pthomas/linuxstamp/linuxstampI/Bom_linuxstamp_rev1.0.5.xls

Sheet: bom
Part | Description | Value | Tolerance | Package | Qty | Digikey pt# | Manufacturer | Manufacturer PT# | Price/1 | Price/100 | Subtotal/1 | Subtotal/100
R1, R2, R12 | Resistor | 10k | 5.00% | 0402 | 3 | 541-10KJCT-ND | Vishay | CRCW040210K0JNED | $0.04 | $0.02 | $0.12 | $0.07
R4, R5, R6, R11, R25, R27, R33 | Resistor | 0 | 5.00% | 0402 | 9 | 541-0.0JCT-ND | Vishay | CRCW04020000Z0ED | $0.04 | $0.02 | $0.36 | $0.21
R3, R7, R8, R19, R24 | Resistor | 200 | 5.00% | 0402 | 5 | 311-200JRCT-ND | Yageo | RC0402JR-07200RL | $0.08 | $0.04 | $0.40 | $0.22
R13 | Resistor | 1.27k | 1.00% | 0402 | 1 | 541-1.27KLCT-ND | Vishay | CRCW04021K27FKED | $0.04 | $0.02 | $0.04 | $0.02
R14 | Resistor | 1.96k | 1.00% | 0402 | 1 | 541-1.96KLCT-ND | Vishay | CRCW04021K96FKED | $0.04 | $0.02 | $0.04 | $0.02
R9-R10, R15-R18 | Resistor | 100k | 5.00% | 0402 | 6 | 541-100KLCT-ND | Vishay | CRCW0402100KFKED | $0.04 | $0.02 | $0.24 | $0.12
R20, R21 | Resistor | 1k | 5.00% | 0402 | 2 | 541-1.00KLCT-ND | Vishay | CRCW04021K00FKED | $0.04 | $0.03 | $0.08 | $0.05
R22 | Resistor | 1M | 5.00% | 1206 | 1 |  |  |  | $0.07 | $0.04 | $0.07 | $0.04
R29, R31 | Resistor | 887k |  | 0402 | 2 |  |  |  | $0.07 | $0.04 | $0.15 | $0.08
R30 | Resistor | 442k |  | 0402 | 1 |  |  |  | $0.07 | $0.04 | $0.07 | $0.04
R32 | Resistor | 197k |  | 0402 | 1 |  |  |  | $0.07 | $0.04 | $0.07 | $0.04
C1-C28, C31-C37, C40, C41, C45, C46, C49, C62 | Capacitor | 100nF | 10.00% | 0402 | 38 | 399-3026-1-ND | Kemet | C0402C104K9PACTU | $0.04 | $0.03 | $1.67 | $0.99
C29, C30, C52, C53 | Capacitor | 18pF | 5.00% | 0403 | 4 | 490-1281-1-ND | Murata | GRM1555C1H180JZ01D | $0.03 | $0.20 | $0.14 | $0.81
C39, C64 | Capacitor | 4.7uF | 20.00% | 0603 | 2 | 445-1417-1-ND | TDK | C1608X5R0J475M | $0.33 | $0.20 | $0.66 | $0.39
C38, C42, C43, C44 | Capacitor | 10uF | 10.00% | 0805 | 4 | 587-1299-1-ND | Tayio Uden | LMK212BJ106KD-T | $0.36 | $0.21 | $1.45 | $0.86
C50, C51 | Capacitor | 12pF | 5.00% | 0402 | 2 | 490-1279-1-ND | Murata | GRM1555C1H120JZ01D | $0.04 | $0.03 | $0.09 | $0.05
C54 | Capacitor | 680p | 10.00% | 0402 | 1 | 399-1027-1-ND | Kemet | C0402C681K5RACTU | $0.03 | $0.02 | $0.03 | $0.02
C55 | Capacitor | 5.6n | 10.00% | 0402 | 1 | PCC2143CT-ND | Panasonic | ECJ-0EB1A563K | $0.03 | $0.02 | $0.03 | $0.02
C56 | Capacitor | 470p | 10.00% | 0402 | 1 | 399-1025-1-ND | Kemet | C0402C471K5RACTU | $0.02 | $0.01 | $0.02 | $0.01
C57 | Capacitor | 4.7n | 10.00% | 0402 | 1 | 399-3072-1-ND | Kemet | C0402C472K5RACTU | $0.02 | $0.01 | $0.02 | $0.01
C63 | Capacitor | 10nF | 10.00% | 0402 | 1 | 399-3066-1-ND | Kemet | C0402C103K5RACTU | $0.02 | $0.01 | $0.02 | $0.01
C58 | Capacitor | 10nF |  | 1206 | 1 | 478-2956-1-ND | AVX | 1206GC102KAT1A | $0.66 | $0.39 | $0.66 | $0.39
C47, C48 | Capacitor | 22pF |  | 0402 | 2 |  |  |  |  |  | $0.00 | $0.00
C65-C68 | Capacitor | 100uF |  | 6032-28 | 4 | 718-1055-1-ND | Vishay/Sprague | 293D107X9010C2TE3 | $0.36 | $0.20 | $1.44 | $0.78
L6, L7 | Inductor | 2.2uH | 10.00% | 1812 | 2 | 495-1757-1-ND | EPCOS | B82432T1222K | $0.49 | $0.37 | $0.98 | $0.74
F1 | FUSE RESETTABLE 2.0A HOLD SMD | .02ohm |  | 1206 | 1 | MF-NSMF200-2CT-ND | Bourns | MF-NSMF200-2 | $0.88 | $0.69 | $0.88 | $0.69
D1 | TVS ZENER DUAL 24W CA 5.6V SOT23 | 5.6V |  | SOT23 | 1 | MMBZ5V6ALT1GOSCT-ND | ON | MMBZ5V6ALT1G | $0.36 | $0.14 | $0.36 | $0.14
JP1 | CONN MINI USB RCPT RA TYPE B SMD |  |  |  | 1 | A31727CT-ND | Tyco | 1734035-2 | $1.76 | $1.06 | $1.76 | $1.06
JP2 | CONN USB JACK TYPE A HORIZON R/A |  |  |  | 1 | 151-1080-ND | EDAC | 690-004-621-013 | $0.81 | $0.57 | $0.81 | $0.57
JP3 | CONN PULSEJACK 1PORT POETHERNET |  |  |  | 1 | 553-1367-ND | Pulse | JK0-0025NL | $7.83 | $4.26 | $7.83 | $4.26
JP5 | TERM BLOCK HEADER 2POS 5MM BLACK |  |  |  | 1 | 277-1645-ND | Phoenix Contact | 1933189 | $0.10 | $0.07 | $0.10 | $0.07
SD1 | CONN SD CARD |  |  |  | 1 | 3M5646CT-ND | 3M | SD-RSMT-2-MQ-WF | $1.70 | $1.00 | $1.70 | $1.00
FB1-FB4 | FERRITE CHIP 30 OHM 1.7A 0402 |  |  | 0402 | 4 | 445-2979-1-ND | TDK | MPZ1005S300C | $0.06 | $0.05 | $0.24 | $0.19
LED1-LED4 | LED GRN HI BRT SS TYPE LO CUR S |  |  | 0603 | 4 | P525CT-ND | Panasonic | LNJ308G8TRA | $0.33 | $0.28 | $1.32 | $1.10
SW1 | SWITCH TACT 6X3.5MM SMD 130GF |  |  | 6x3.5 | 1 | 450-1140-ND | Tyco / Alcoswitch | FSMSM | $0.89 | $0.46 | $0.89 | $0.46
U1 | IC ARM9 MCU 208 PQFP |  |  | LQFP208 | 1 | AT91RM9200-QU-002-ND | Atmel | AT91RM9200-QU-002 | $16.65 | $13.58 | $16.65 | $13.58
U2 | IC SDRAM 256MB 133MHZ 54-TSOP | 32MB SDRAM |  | TSOPII-54 | 1 | 557-1059-1-ND | Micron | MT48LC16M16A2P-75:D TR | $9.92 | $6.79 | $9.92 | $6.79
U3 | IC TXRX PHY 10/100 3.3V 48LQFP |  |  | TQFP48 | 1 | 576-1028-1-ND | Micrel | KS8721BL | $3.98 | $2.48 | $3.98 | $2.48
U4 | IC EMI FLTR/LINE TERM SOT323-5L |  |  | SOT323-5 | 1 | 497-3086-1-ND | ST Microelectronics | USBDF01W5 | $0.79 | $0.48 | $0.79 | $0.48
U5 | IC DATAFLASH 64M 2.7 DUAL 8CASON | 8MB Dataflash |  | CASON-8 | 1 | AT45DB642D-CNU-ND | Atmel | AT45DB642D-CNU | $6.99 | $4.65 | $6.99 | $4.65
U6 | IC FTDI FT232RQ USB-SRL 32-QFN |  |  | QFN32 | 1 | 604-00047CT-ND | FTDI | FT232RQ | $8.40 | $3.11 | $8.40 | $3.11
U7 | IC REG DC/DC DUAL STEPDOWN 10DFN |  |  | DFN-10 | 1 | LTC3407IDD-2#PBF-ND | Linear | LTC3407-2 | $4.21 | $3.47 | $4.21 | $3.47
X1 | CRYSTAL 18.432MHZ 18PF FUND SMD | 18.432Mhz |  | 3.2x2.5 | 1 | 535-9135-1-ND | Abracon | ABM8-18.432MHZ-B2-T | $1.93 | $1.23 | $1.93 | $1.23
X2 | CRYSTAL 32.768KHZ 12.5PF SMD | 32.768khz |  | MM20SS | 1 | XC488CT-ND | ECS | ECS-.327-12.5-17-TR | $1.08 | $0.72 | $1.08 | $0.72
X3 | CRYSTAL 25.000MHZ 18PF FUND SMD | 25.000Mhz |  | 3.2x2.5 | 1 | 535-9140-1-ND | Abracon | ABM8-25.000MHZ-B2-T | $1.93 | $1.23 | $1.93 | $1.23
No populate Designators
R26, R28
JP4 | CONN HEADER 10POS .100" VERT TIN |  |  |  | 1 | WM17451-ND | Molex/Waldom | 15-91-2100 | $1.01 | $0.59 | $1.01 | $0.59
C60 |  | 100pF |  | 0402 | 1 |  |  |  |  |  | $0.00 | $0.00
Non Soldered
JP5 connecter | TERM BLOCK PCB 2POS 5.0MM GREEN |  |  |  | 1 | 277-1607-ND | Phoenix Contact | 1934861 | $0.34 | $0.25 | $0.34 | $0.25
Total |  |  |  |  |  |  |  |  |  |  | $81.98 | $54.11

Sheet: changelog
Date | Version | Changes
2007-04-19 | 1.0.1 | Added JP5 and connector for JP5, and C41
 |  | Changed C39, C64 tolerence to +/- 20%
 |  | changed C50, C51
 |  | added and item column
2007-04-29 | 1.0.2 | Added c45, c46
 |  | Added F1
2007-05-11 | 1.0.3 | Switched ethernet jack
2008-04-26 | 1.0.4 | added some subs, and passives for power supply
