pthomas/linuxstamp/linuxstampII/bom_ls2_1.0.7.xls

Sheet: wanda_100_bom
Part | Description | Value | Tolerance | Package | Qty | Digikey pt# | Manufacturer | Manufacturer PT# | Price/1 | Price/100 | Subtotal/1 | Subtotal/100
R1, R4, R5, R6, R10 |  | 470k |  | 0402 | 5 | 541-470KLCT-ND | Vishay/Dale | CRCW0402470KFKED | $0.08 | $0.04 | $0.42 | $0.22
R14 |  | 665k |  | 0402 | 1
R12 |  | 887k |  | 0402 | 2 | 541-887KLCT-ND | Vishay/Dale | CRCW0402887KFKED | $0.08 | $0.04 | $0.17 | $0.09
R13 |  | 196k |  | 0402 | 1 | 541-196KLCT-ND | Vishay/Dale | CRCW0402196KFKED | $0.08 | $0.04 | $0.08 | $0.04
R11 |  | 442k |  | 0402 | 1 | 541-442KLCT-ND | Vishay/Dale | CRCW0402442KFKED | $0.08 | $0.04 | $0.08 | $0.04
R15 |  | 200 |  | 0402 | 1 | 541-200LCT-ND | Vishay/Dale | CRCW0402200RFKED | $0.08 | $0.04 | $0.08 | $0.04
R20, R23, R24, R25, R30, R38 |  | 100k |  | 0402 | 6 | 541-100KLCT-ND | Vishay/Dale | CRCW0402100KFKED | $0.08 | $0.04 | $0.50 | $0.27
R27 |  | 6.49k |  | 0402 | 1 | 541-6.49KLCT-ND | Vishay/Dale | CRCW04026K49FKED | $0.08 | $0.04 | $0.08 | $0.04
R8, R29 |  | 1k |  | 0402 | 2 | 541-1.00KLCT-ND | Vishay/Dale | CRCW04021K00FKED | $0.08 | $0.04 | $0.17 | $0.09
R9, R19, R39, R40 |  | 10k |  | 0402 | 4 | 541-10.0KLCT-ND | Vishay/Dale | CRCW040210K0FKED | $0.08 | $0.04 | $0.33 | $0.18
R31, R32, R33, R34 |  | 49.9 |  | 0402 | 4 | 541-49.9LCT-ND | Vishay/Dale | CRCW040249R9FKED | $0.08 | $0.04 | $0.33 | $0.18
R17, R18, R21, R22, R26, R28 |  | 0 |  | 0402 | 6 | 541-0.0JCT-ND | Vishay/Dale | CRCW04020000Z0ED | $0.07 | $0.04 | $0.44 | $0.24
C1, C2, C3, C4, C5, C6, C7, C8, C9, C10, C11, C12, C13, C14, C15, C16, C17, C18, C19, C20, C21, C22, C23, C24, C25, C33, C34, C38, C45, C48, C50, C51, C52, C56, C57 | Capacitor | 100nF | 10.00% | 0402 | 35 | 399-3521-1-ND | Kemet | C0402C104K4RACTU | $0.03 | $0.02 | $0.91 | $0.55
C28, C29, C30, C31 | Capacitor | 18pF |  | 0402 | 4 | 490-1281-1-ND | Murata | GRM1555C1H180JZ01D | $0.02 | $0.01 | $0.09 | $0.05
C26, C27 | Capacitor | 12.5pF |  | 0402 | 2 | 490-1279-1-ND | Murata | GRM1555C1H120JZ01D | $0.02 | $0.01 | $0.04 | $0.03
C35, C36, C37, C39, C40, C43, C44 | Capacitor | 10uF | 10.00% | 0805 | 7 | 399-3138-1-ND | Kemet | C0805C106K9PACTU | $0.24 | $0.14 | $1.69 | $1.00
C41, C42 | Capacitor | 22pF |  | 0402 | 2 | 399-1015-1-ND | Kemet | C0402C220J5GACTU | $0.02 | $0.01 | $0.05 | $0.03
C47, C49, C54, C55 | Capacitor | 100uF |  | 6032-28 | 4 | 718-1055-1-ND | Vishay/Sprague | 293D107X9010C2TE3 | $0.39 | $0.18 | $1.56 | $0.72 | D | 500 |  | 90
C53 | Capacitor | 100pF |  | 0402 | 1 | 399-3194-1-ND | Kemet | C0402C101J5GACTU | $0.02 | $0.01 | $0.02 | $0.01
C46 | Capacitor | 1nF | 10.00% | 0402 | 1 | 399-1032-1-ND | Kemet | C0402C102K5RACTU | $0.03 | $0.02 | $0.03 | $0.02
D2 | TVS | 3V |  | Sot23 | 1 | MMBZ5V6AL-FDICT-ND | Diodes Inc | MMBZ5V6AL-7-F | $0.42 | $0.18 | $0.42 | $0.18
L6, L7 | Inductor | 2.2uH | 10.00% | 1812 | 2 | 495-1757-6-ND | EPCOS | B82432T1222K | $0.49 | $0.58 | $0.98 | $1.16 | D | 280 | 7 | 162.288 | 169.288
FB1, FB2, FB3, FB4, FB5, FB6 | FERRITE CHIP 30 OHM 1.7A 0402 |  |  | 0402 | 6 | 445-2979-1-ND | TDK | MPZ1005S300C | $0.06 | $0.05 | $0.36 | $0.29
LED1(3.3v) | LED GRN HI BRT SS TYPE LO CUR S |  |  | 0603 | 1 | P525DKR-ND | Panasonic | LNJ308G8TRA | $0.33 | $0.28 | $0.33 | $0.28 | D | 140 | 7 | 38.668 | 45.668
JP1 | Memory Card Headers MICROSD 8P P/P SMT POLARIZED |  |  |  | 1 | 3M5607DKR-ND | 3M | 2908-05WB-MG | $1.22 | $0.93 | $1.22 | $0.93 | D | 140 | 7 | 130.508 | 137.508
JP2 | CONN USB JACK TYPE A HORIZON R/A |  |  |  | 1 | 151-1080-ND | EDAC | 690-004-621-013 | $0.81 | $0.57 | $0.81 | $0.57 | D | 140 |  | 80.08 | 80.08
JP3 | CONN PULSEJACK 1PORT 10/100B-TX |  |  |  | 1 | 553-1349-ND | Pulse | J0026D21BNL | $7.05 | $3.20 | $7.05 | $3.20 | A | 140
 |  |  |  |  |  |  |  | J0026D21FNL
JP5 | CONN HEADER VERT 5POS .100 TIN |  |  |  | 1 | A31115-ND | Tyco | 3-644456-5 | $0.33 | $0.21 | $0.33 |  | D | 140 |  | 29.89 | 29.89
JP6, JP7 | CONN HEADER 40POS .8MM DUAL SMD |  |  |  | 2 | 609-1670-1-ND | FCI | 61083-042422LF | $3.64 | $1.33 | $7.28 | $0.21 | D | 140 |  | 29.89 | 29.89
 |  |  |  |  |  | 609-1669-1-ND | FCI | 61083-042402LF |  |  |  | $2.66 | A | 800
SW1 (RESET) | SWITCH TACT 6X3.5MM SMD 130GF |  |  |  | 1 | 450-1140-ND | Tyco / Alcoswitch | FSMSM | $0.58 | $0.14 | $0.58
U1 | IC ARM9 MCU 217-LFBGA |  |  | 217-LFBGA | 1 |  | Atmel | AT91SAM9G20 | $14.62 | $8.00 | $14.62 | $0.14 | A | 1000
U2 | IC SDRAM 256MB 133MHZ 54-TSOP | 32MB SDRAM |  | TSOPII-54 | 1 | 557-1059-1-ND | Micron | MT48LC16M16A2P-75:D TR | $7.84 | $5.00 | $7.84 | $8.00 | N | 125
U3 | IC NAND FLASH 2GB 3.3V 48-TSOP | 256MB Nand Flash |  | 48-TSOP | 1 | 557-1355-1-ND | Micron | MT29F2G08AADWP-ET:D TR | $8.26 | $5.80 | $8.26 | $5.00 | N | 100
U4 | IC TXRX PHY 10/100 LV/LP 32-MLF |  |  | 32-MLF | 1 | 576-1645-1-ND | Micrel | KSZ8041NL TR | $2.27 | $1.41 | $2.27 | $5.80 | N | 100
U6 | IC EMI FLTR/LINE TERM SOT323-5L |  |  | SOT323-5 | 1 | 497-3086-1-ND | ST Microelectronics | USBDF01W5 | $0.77 | $0.53 | $0.77 | $1.41 | D | 110 | 7 | 155.54 | 162.54
U7 | IC REG DC/DC DUAL STEPDOWN 10DFN |  |  | DFN-10 | 1 | LTC3407IDD-2#PBF-ND | Linear | LTC3407-2 | $5.20 | $3.06 | $5.20 | $0.53 | D | 140 | 7 | 73.92 | 80.92
 |  |  |  |  |  | LTC3407AEDD#PBF-ND | Linear | LTC3407AEDD#PBF |  |  |  | $3.06 | D | 140 |  | 428.4 | 428.4
X1 | CRYSTAL 18.432MHZ 18PF FUND SMD | 18.432Mhz |  | 3.2x2.5 | 1 | 535-9135-1-ND | Abracon | ABM8-18.432MHZ-B2-T | $2.06 | $1.24 | $2.06
 |  |  |  |  |  | 300-8670-1-ND | Citizen | CS325-18.432MABJ-UT |  |  |  | $1.24 | D | 140 | 7 | 173.25 | 180.25
X2 | CRYSTAL 32.768KHZ 12.5PF SMD | 32.768khz |  |  | 1 | XC488CT-ND | ECS | ECS-.327-12.5-17-TR | $0.71 | $0.43 | $0.71
 |  |  |  |  |  | 535-9166-1-ND | Abracon | ABS25-32.768KHZ-T |  |  |  | $0.43 | D | 140 | 7 | 59.85 | 66.85
X3 | CRYSTAL 25.000MHZ 18PF FUND SMD | 25.000Mhz |  | 3.2x2.5 | 1 | 535-9140-1-ND | Abracon | ABM8-25.000MHZ-B2-T | $1.31 | $0.79 | $1.31
 |  |  |  |  | 1 | 887-1132-1-ND | TXC Technology | 7M-25.000MAAJ-T |  |  |  | $0.79 | D | 140 | 7 | 110.25 | 117.25
No populate
D1 |  |  |  |  |  |  |  |  |  |  | $69.48 | $39.72
R2, R3, R7, R16, R35, R36, R37 |  |  |  |  |  |  |  |  |  |  |  |  |  |  |  | subtotal | 1528.534
U5
C32, C58, C59
LED2 (1V)
JP4

Sheet: Total
BOM cost | $39.72 | Testing shop rate | $60.00
preprogramming NAND | $2.00 | Testing time | 10 | minutes
BOM handling | $7.94 | Testing cost | $10.00
PCB manufacturing | $9.00
Assembly | $26.00
Packaging | $1.00
Testing | $10.00
Total | $95.66
