pthomas/linuxstamp/linuxstampI/pcb/pdf/linuxstamp121-bottom.pdf

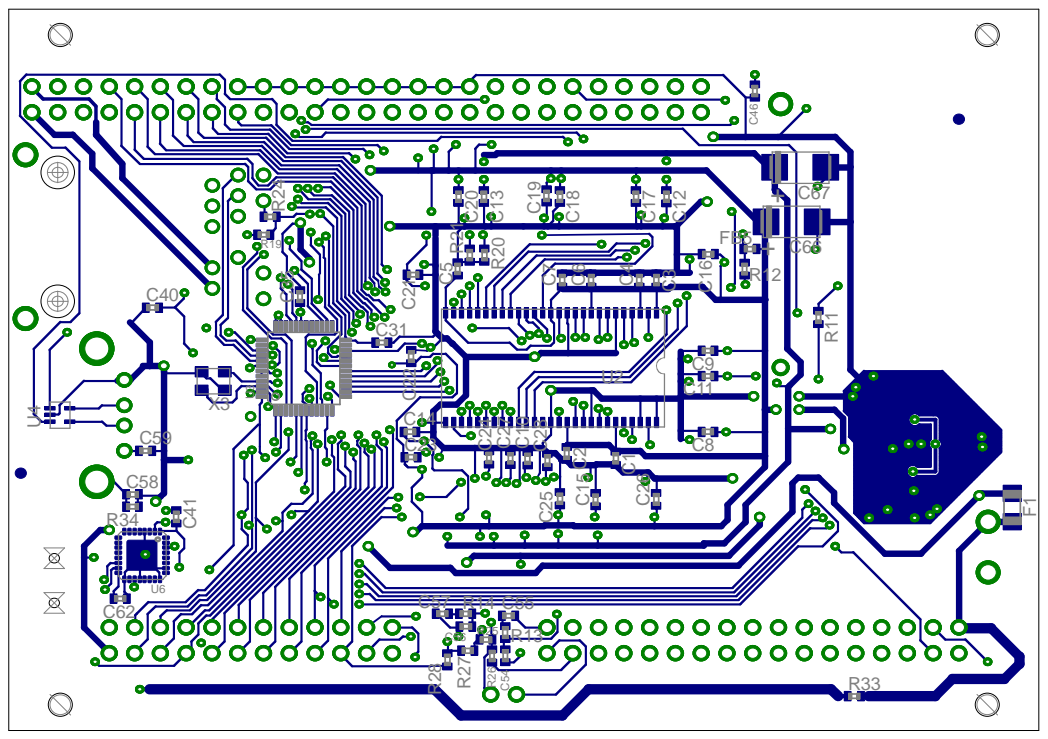
[picture p1: page 1]
