pthomas/linuxstamp/linuxstampI/pcb/pdf/linuxstamp121-top.pdf

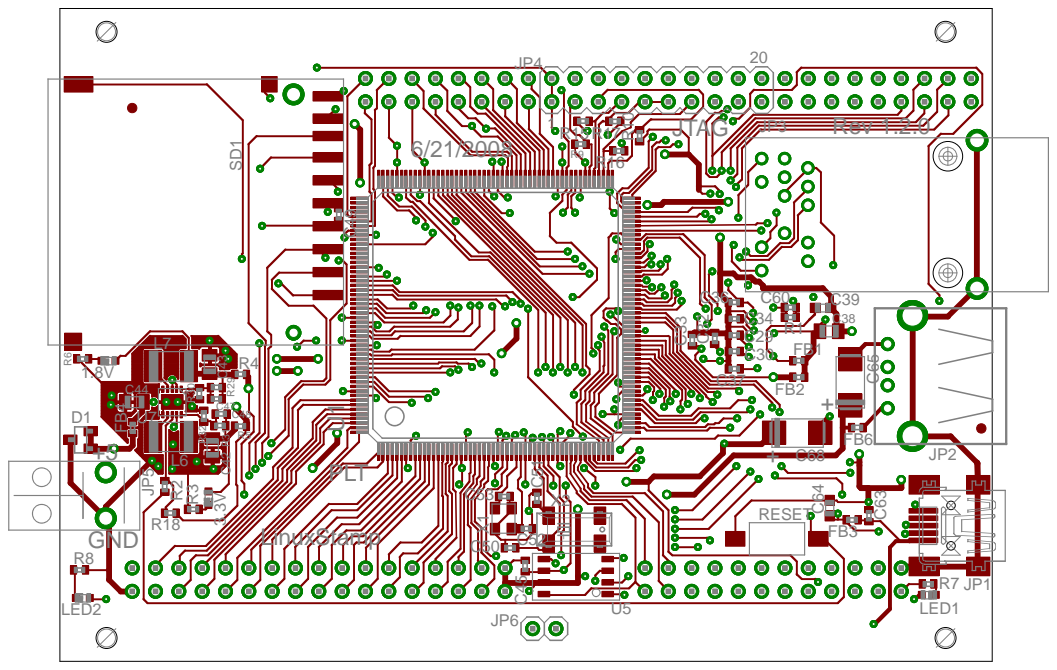
[picture p2: page 1]
